atiretoo/french_cleats/assets/pegboard/pegboard-spacer.stl

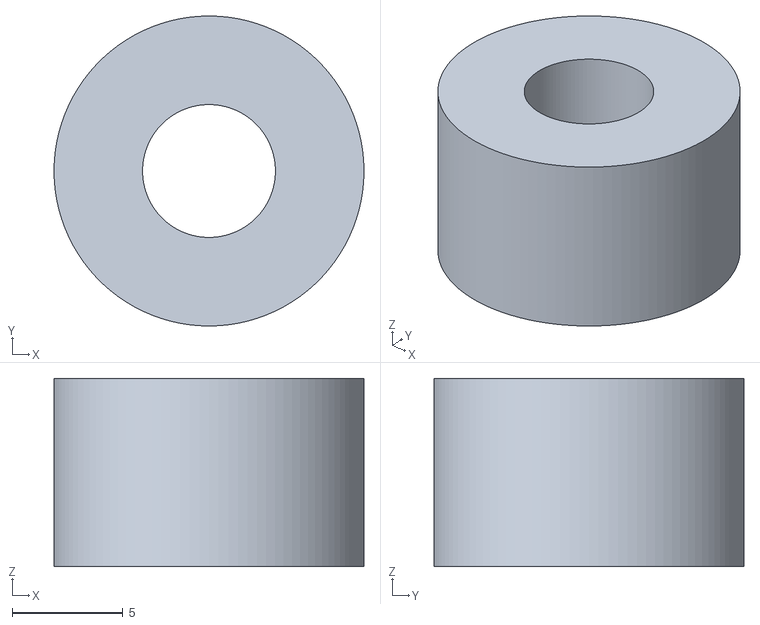
[picture p1: CAD file, 2026-10-31]
assets/pegboard/pegboard-spacer.stl
14.0 x 14.0 x 8.50
