atiretoo/french_cleats/assets/pegboard/pegboard-panel.stl

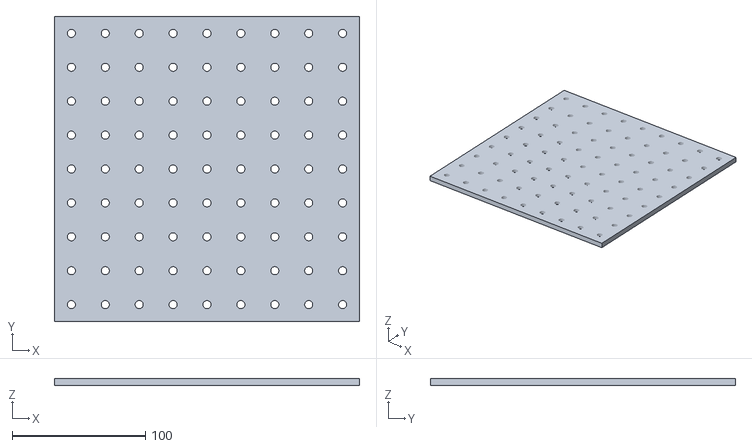
[picture p2: CAD file, 2026-10-31]
assets/pegboard/pegboard-panel.stl
228.5 x 228.5 x 5.30
