atiretoo/french_cleats/(commit log)

2026-09-14 feat: add script to generate nut pusher tool
2026-09-14 feat: add corner clamp holder script
2026-09-14 feat: add corner clamp depth tester
2026-09-14 feat: update corner clamp holder to 1U with flat bottom and 15mm depth
2026-09-15 fix: adjust fin length to exact hypotenuse and add 0.1mm gap test
2026-09-15 feat: finalize fin test model with 0.07mm single-sided gap
2026-09-15 Refactor export mechanism for STLs, ensuring exports/stl directory and optimal print orientation
2026-09-15 Enable auto-rotation for cleats so they export standing on end for optimal print strength
2026-09-15 feat: update fin test to 4-fin single-sided array for wider gaps (0.07 to 0.10mm)
2026-09-15 Update chisel holder to support variable slot depths and widths, set larger chisels to 8mm depth
2026-09-15 feat: update fin test to 0.1mm gap with sharp knife-edge taper
2026-09-15 feat: taper Y-ends of the fin to a point over 2.0mm to fix blunt U-turns
2026-09-15 feat: use long needle taper for the top edge of the fin to ensure a single extrusion line
2026-09-15 fix: correct CadQuery loft vector sign bug that caused the taper cut to miss the fin
2026-09-16 Add script to generate large circular saw brackets supporting a 300mm hypotenuse
2026-09-16 Update saw bracket: thin web to 10mm, add triangular cutout, apply 5mm inside fillets, add M3 captive nut slots
2026-09-16 Add drilling template generation for circular saw bracket
2026-09-16 Update saw bracket to offset web asymmetrically, generating explicit left and right handed versions with optimal print orientation
2026-09-16 Fix orientation matrix so left and right brackets load right-side up in slicer
2026-09-16 Rotate captive nut slots by 90 degrees to make flats perpendicular to bolt axis
2026-09-16 Fix cutout geometry: correct -11 offset bug that caused tapering, and increase hypotenuse offset to 25mm so the web is a consistent 15mm from the inner flange
2026-09-16 Fix captive nut slot dimensions and end stops to perfectly fit standard M3 hex nuts
2026-09-17 Add 1mm push holes through all captive nut slots (cleats and saw brackets) to allow easy nut removal
2026-09-17 Add 30-degree diagonal push holes to multiconnect adapter nut slots
2026-09-17 Add upside-down power tool holder generator
2026-09-17 Fix U-slot length so the arc perfectly terminates at 120mm without cutting into the baseplate
2026-09-17 Reduce shelf thickness to 5mm to free up top screw holes, and add 4mm fillets to the inner corners where the shelf and braces meet the backplate
2026-09-17 Add magnetic and cam holders for thin tools
2026-09-17 Simplify magnetic holder by embedding magnets directly into the backplate
2026-09-17 Increase nut push hole diameter to 1.5mm to allow paper clips and resistor leads to fit and not buckle
2026-09-17 Add prototype for Shooo cam mechanism on 2U baseplate
2026-09-18 Parameterize magnetic holder to support custom magnet sizes and counts
2026-09-18 Anchor shooo cam holes and pin relative to the top edge to match axle cap alignment
2026-09-18 Fix double Y offset bug causing holes to disappear outside block bounds
2026-09-18 Revert to bottom-anchored coordinates to shift holes and pin toward the groove side of the baseplate
2026-09-18 feat: Replace rotate_for_printing boolean with explicit print_orientation strings ('left_down', 'back_down', 'top_down', etc) and apply to power tool & shooo cam holders
2026-09-18 docs: Add print orientation override rules to design patterns
2026-09-18 fix: Adjust shooo baseplate pin Y-offset to match user measurement of 19.83mm from groove edge
2026-09-18 feat: Add printable nut pusher auxiliary tool to easily insert captive nuts into tight gaps
2026-09-18 feat: Add a 120-degree V-notch to the tip of the nut pusher to perfectly cup the point of the hex nut and prevent slipping
2026-09-18 Refactor CQ Workplanes from XZ to ZX and invert chained operations
2026-09-18 feat: Move captive nut slot forward, extend bolt clearance hole, and add --tilt-fin support for 45-deg angled prints
2026-09-18 fix: Change the 45-degree tilt fin orientation from X-axis to Y-axis so the horizontal bridge in the captive nut slot becomes a 45-degree angle
2026-09-19 fix: Calculate fin geometry using the actual U-based baseplate width rather than the tighter mechanism width, so it accurately anchors the left edge directly to the build plate Z=0
2026-09-19 fix: Change support_fin gap parameter from normal_gap to z_gap to accurately control the slicing gap parallel to the build plate
2026-09-19 test: modify generate_fin_test to generate 3 fins with 0.05, 0.07, and 0.10 mm gaps
2026-09-19 fix: increase support_fin tip_width to 0.4mm to accommodate 0.4mm nozzle extrusion width
2026-09-20 test: use Assembly to apply explicit component names to step file
2026-09-20 fix: update export_stl to natively handle and preserve CadQuery Assembly components and names
2026-09-20 fix: rename 'M' to 'Mags' in magnetic holder filename to prevent confusion with metric screw sizes
2026-09-20 feat: set default support_fin gap to 0.01mm and document corner breakaway strategy
2026-09-20 fix: set print_orientation to face_down for opengrid_adapter to prevent severe overhangs
2026-09-21 fix: change opengrid_adapter print_orientation to top_down per user test
2026-09-21 fix: change opengrid_adapter print_orientation to top_down
2026-09-21 feat: default gridfinity shelf to print at 45 degrees with perfectly vertical support fins
2026-09-21 fix: adjust bolt hole and nut slot down by 2.5mm in shooo cam holder
2026-09-21 fix: change gridfinity shelf print_orientation to back_down
2026-09-22 docs: establish invariant object reference frame rule and update export_model docs
2026-09-22 feat: default gridfinity shelves to 45-degree print orientation with support fins
2026-09-23 chore: remove clamp holder and corner clamp holder from v1.2.1 release (pending v2.0 redesign)
2026-09-23 feat: add perpendicular shelf magnetic holder style with triangular brace
2026-09-23 feat: increase chisel holder shelf depth to 38mm and add 60-degree hole chamfers
2026-09-23 feat(hsw): add Honeycomb Storage Wall to French Cleat adapter
    [insert-empty.step]
2026-09-23 feat(v2.0): integrate digital assets, shallow groove standard, adaptor redesign, and perpendicular magnetic holder
    [embed-back-end.step, insert-empty.step, opening-raw-slot-back.step, raw-slot-back.step, round.step, slot-opening.step, top-back.step]
2026-09-23 fix(v1.2.1): set correct print orientation for slot, screwdriver, and hook holders, and update batch scripts
2026-09-23 docs: add Printables description markdown and RTF export
2026-09-23 docs: add attributions section and MFC nickname to Printables description
2026-09-24 docs: add Printables link and update title to Modular French Cleat (MFC) System v1.2.1
2026-09-24 feat(magnetic): align perp shelf side with 1U holders, add 2x19mm variant, retire 2x10mm holders
2026-09-24 feat(p1.2): implement Slant3D edge standards (back/bed chamfers, top/shelf fillets) and retire generate_cam_holder
2026-09-24 fix(groove-ridge): standardize 45-deg angles, narrower ridge (0.45mm side clearance), and cut down crest (0.70mm depth clearance)
2026-09-26 fix(standards): lock in 0.20mm ridge side clearance for v2.0 standard
2026-10-01 feat: Add default 45-degree right-tilt print orientation for hook holders with support fins at the central groove edges
2026-10-02 fix: disable post-rotation apply_bed_chamfer logic to prevent unwanted chamfers on build plate edges
2026-10-07 feat: add 3u deep slot holder for try squares
2026-10-07 feat: Add default 45-degree right-tilt print orientation for slot holders with kickstand support fins
2026-10-07 fix: correct coordinate translations and kickstand placement for slot holder 45-degree printing
2026-10-07 fix: drop holder by an extra 1.41mm to perfectly seat chamfered edge on print bed
2026-10-12 feat: add 1U-4U standard pegboard and IKEA Skadis mounts with pyramid-scoop supports
2026-10-12 feat: add 26 gauge sheet metal tool holder with 45-degree pocket
    - Capture 26 gauge sheet metal (~0.6 mm thick) behind 45-degree V-groove retaining lips for magnetic tool mounting
    - 26 mm widened pocket floor with 0.25 mm vertical section to ensure 0.3 mm clearance at top edge of metal strip
    - 1.25 mm total pocket depth with 0.5 mm retaining overhang at face
    - Full-length projection extending to bottom of holder with 45-degree bottom edge and 1.0 mm rim
    - 1.0 mm retention tabs at corners leaving 24 mm open bottom span for flush tool mounting and push ejection
    - 4.0 mm structural fillet and support-free right_down print orientation
    - Update generate_all scripts
2026-10-13 feat: add French Cleat claw hammer tool holder with truncated front shelf
2026-10-14 feat: shorten rear shelf to 5mm from backplate and elevate front claw support with rounded edges
2026-10-14 refactor: remove multiconnect from all tool holders, thin claw hammer shelf to 5mm with 30mm drop
2026-10-15 fix(claw-hammer): move slot 5mm further from backplate, deepen slot by 3mm to 29mm, lengthen shelf by 8mm to 100mm
2026-10-15 feat: redesign clamp holder with 4U width, 1cm clamp head support bump, and widened slots
2026-10-15 feat: move head support bumps to slot opening side with 45-degree self-supporting angle
2026-10-15 fix(tolerances): increase captive nut slot tolerances to +0.3mm (5.80x2.70mm for M3)
2026-10-15 fix(claw-hammer): widen slot depth to 40mm and increase shelf depth to 111mm
2026-10-16 feat: lengthen head support bumps by 10mm (bump_flat_width=24mm)
2026-10-16 fix(claw-hammer): set front claw platform to 10mm and shelf depth to 105mm
2026-10-17 feat: add 60-degree swept hose and extension cord holder (7U)
    - Add generate_hose_holder.py creating a pure 60-degree swept cradle with UNIT groove mount
    - Add side-down optimal print orientation with 35 cm^2 bed contact and continuous tensile perimeter loops
    - Update generate_all.bat and generate_all.sh to include hose holder generation
2026-10-17 chore: release v1.2.2 with increased nut slot tolerances and print orientation fixes
2026-10-31 chore: finalize v2.0.0 BRep refactor, CAD-space STEP export, and release docs
